phtty/nova_sensors/3d model/SW-SMD_2P-L5.1-W6.2-P2.54-LS9.4-BL.step

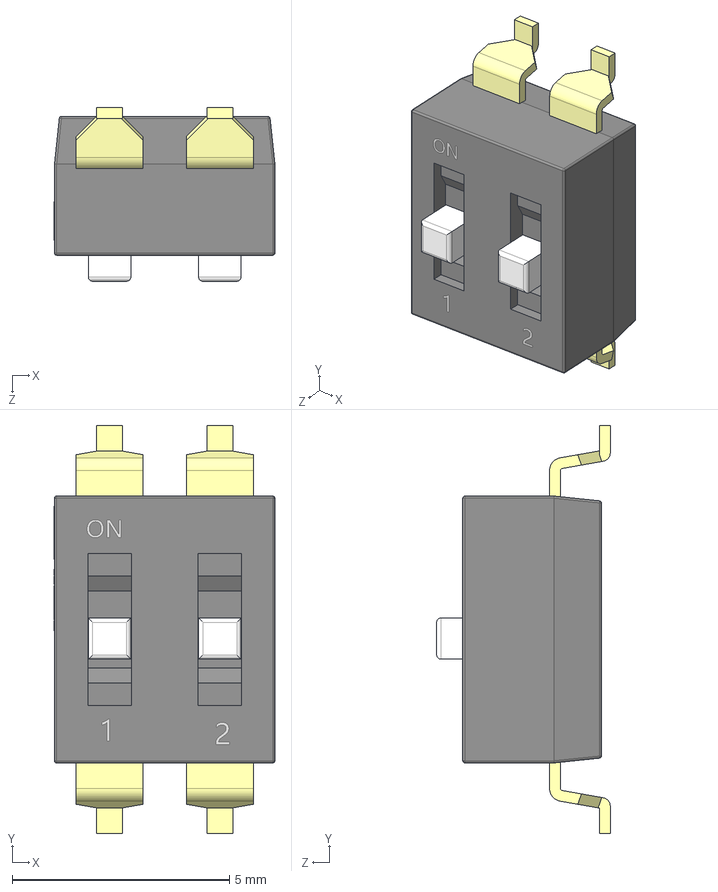
[picture p1: CAD file, 2026-08-21]
3d model/SW-SMD_2P-L5.1-W6.2-P2.54-LS9.4-BL.step
5.09 x 9.40 x 4.00 mm
