phtty/nova_sensors/3d model/L_12x12mm_H8mm.step

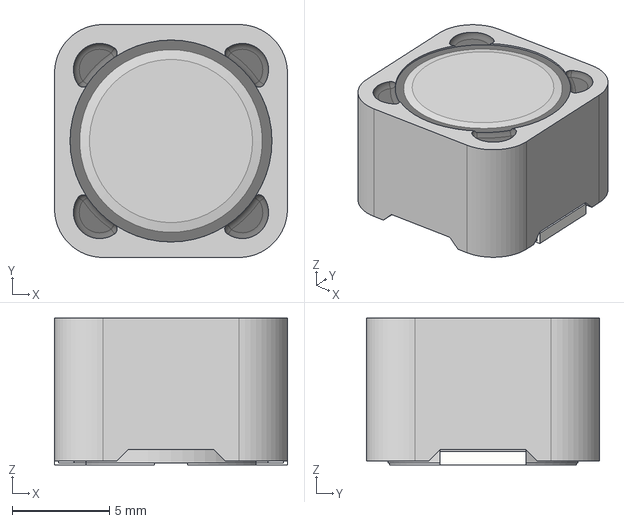
[picture p2: CAD file, 2026-08-21]
3d model/L_12x12mm_H8mm.step
12.0 x 12.0 x 7.56 mm
