phtty/nova_sensors/3d model/1812L125_16DR.stp

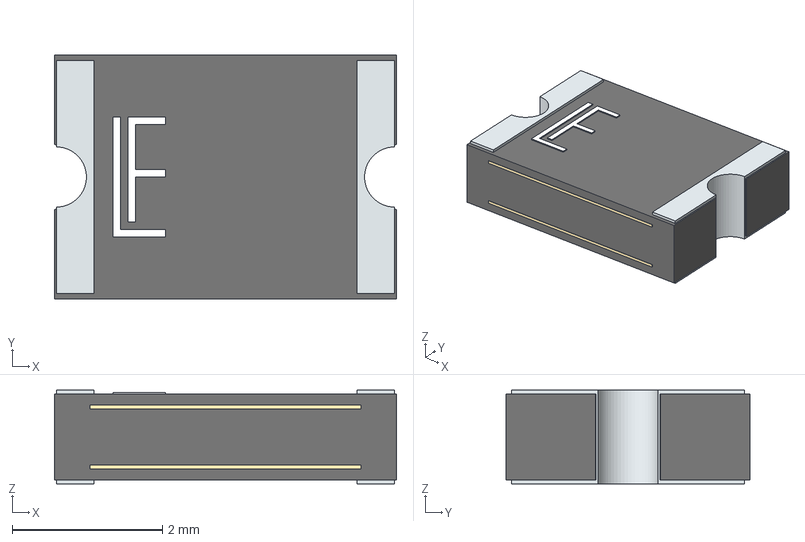
[picture p3: CAD file, 2026-08-21]
3d model/1812L125_16DR.stp
4.55 x 3.25 x 1.25 mm
Intersect
Terminal
solidWriting
