phtty/nova_sensors/nova_sensors.kicad_pcb

## KiCad design nova_sensors.kicad_pcb (2026-09-30)

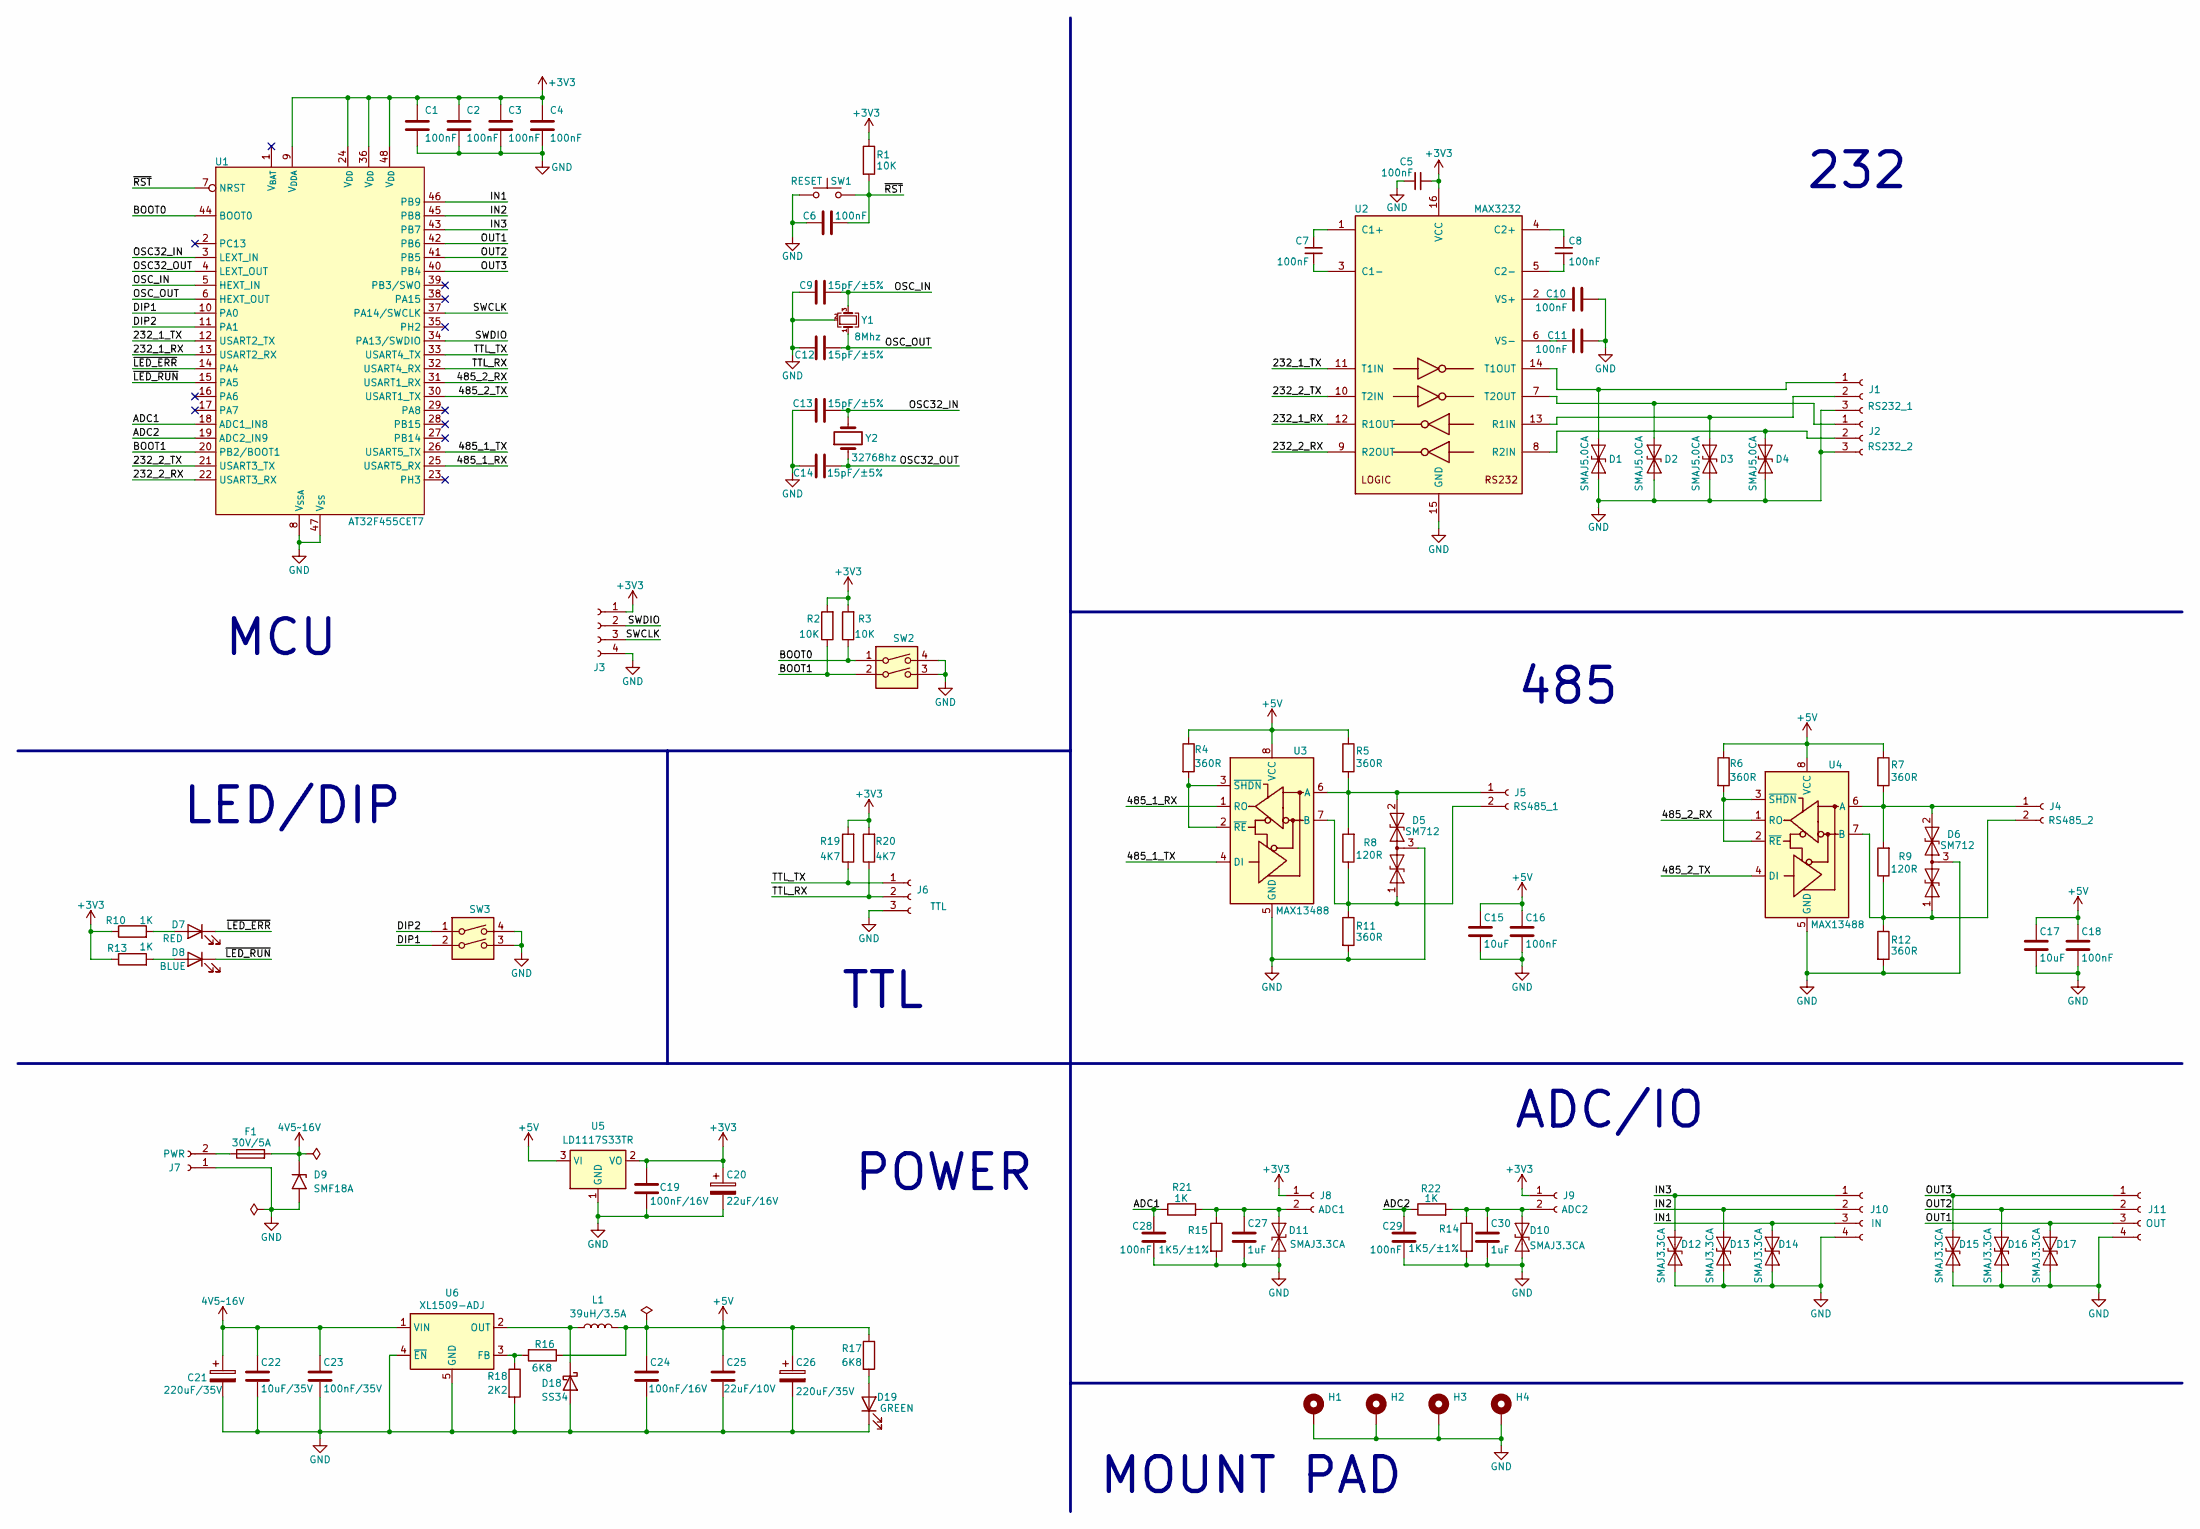
[picture p4: schematic nova_sensors.kicad_sch, 诺瓦传感器驱动板]

Parts:
C1, C2, C3, C4, C5, C6, C7, C8, C10, C11, C16, C18, C28, C29: 100nF; C_0603_1608Metric
C9, C12, C13, C14: 15pF/±5%; C_0603_1608Metric
C15, C17: 10uF; C_0603_1608Metric
C19, C24: 100nF/16V; C_0603_1608Metric
C20: 22uF/16V; CP_Elec_4x5.7
C21, C26: 220uF/35V; CP_Elec_8x10
C22: 10uF/35V; C_0603_1608Metric
C23: 100nF/35V; C_0603_1608Metric
C25: 22uF/10V; C_0603_1608Metric
C27, C30: 1uF; C_0603_1608Metric
D1, D2, D3, D4: SMAJ5.0CA; D_SMA
D5, D6: SM712; SOT-23
D7: RED; LED_0603_1608Metric_Pad1.05x0.95mm_HandSolder
D8: BLUE; LED_0603_1608Metric_Pad1.05x0.95mm_HandSolder
D9: SMF18A; D_SMF
D10, D11, D12, D13, D14, D15, D16, D17: SMAJ3.3CA; D_SMA
D18: SS34; D_SMA
D19: GREEN; LED_0603_1608Metric_Pad1.05x0.95mm_HandSolder
F1: 30V/5A; Fuse_1812_4532Metric_Pad1.30x3.40mm_HandSolder
H1: MountingHole_Pad; MountingHole_3.2mm_M3_Pad
H2, H3, H4: MountingHole_Pad; MountingHole_3.5mm_Pad
J1, J2, J6: Conn_01x03_Socket; PhoenixContact_MSTBA_2,5_3-G-5,08_1x03_P5.08mm_Horizontal
J3: Conn_01x04_Socket; JST_XH_B4B-XH-A_1x04_P2.50mm_Vertical
J4, J5, J7, J8, J9: Conn_01x02_Socket; PhoenixContact_MSTBA_2,5_2-G-5,08_1x02_P5.08mm_Horizontal
J10, J11: Conn_01x04_Socket; PhoenixContact_MSTBA_2,5_4-G-5,08_1x04_P5.08mm_Horizontal
L1: 39uH/3.5A; L_12x12mm_H8mm
R1, R2, R3: 10K; R_0603_1608Metric
R4, R5, R6, R7, R11, R12: 360R; R_0603_1608Metric
R8, R9: 120R; R_0603_1608Metric
R10, R13, R21, R22: 1K; R_0603_1608Metric
R14, R15: 1K5/±1%; R_0603_1608Metric
R16, R17: 6K8; R_0603_1608Metric
R18: 2K2; R_0603_1608Metric
R19, R20: 4K7; R_0603_1608Metric
SW1: SW_Push; SW_SPST_PTS647_Sx50
SW2, SW3: SW_DIP_x02; SW-SMD_2P-L5.1-W6.2-P2.54-LS9.4-BL
U1: AT32F455CET7; LQFP-48_7x7mm_P0.5mm
U2: MAX3232; SOIC-16_3.9x9.9mm_P1.27mm
U3, U4: MAX13488; SOIC-8_3.9x4.9mm_P1.27mm
U5: LD1117S33TR; SOT-223-3_TabPin2
U6: XL1509-ADJ; SOIC-8_3.9x4.9mm_P1.27mm
Y1: 8Mhz; Crystal_SMD_3225-4Pin_3.2x2.5mm
Y2: 32768hz; Crystal_SMD_3215-2Pin_3.2x1.5mm

Connections:
4V5~16V: C21.1, C22.1, C23.1, D9.1 (A1), F1.2, U6.1 (VIN)
+3V3: C1.1, C2.1, C3.1, C4.1, C5.2, C19.1, C20.1, J3.1, J8.1, J9.1, R1.1, R2.2, R3.2, R10.1, R13.1, R19.2, R20.2, U1.9 (V_{DDA}), U1.24 (V_{DD}), U1.36 (V_{DD}), U1.48 (V_{DD}), U2.16 (VCC), U5.2 (VO)
+5V: C15.1, C16.1, C17.1, C18.1, C24.1, C25.1, C26.1, L1.2, R4.1, R5.1, R6.1, R7.1, R16.1, R17.1, U3.8 (VCC), U4.8 (VCC), U5.3 (VI)
/232_1_RX: U1.13 (USART2_RX), U2.12 (R1OUT)
/232_1_TX: U1.12 (USART2_TX), U2.11 (T1IN)
/232_2_RX: U1.22 (USART3_RX), U2.9 (R2OUT)
/232_2_TX: U1.21 (USART3_TX), U2.10 (T2IN)
/485_1_RX: U1.25 (USART5_RX), U3.1 (RO)
/485_1_TX: U1.26 (USART5_TX), U3.4 (DI)
/485_2_RX: U1.31 (USART1_RX), U4.1 (RO)
/485_2_TX: U1.30 (USART1_TX), U4.4 (DI)
/ADC1: C28.1, R21.1, U1.18 (ADC1_IN8)
/ADC2: C29.1, R22.1, U1.19 (ADC2_IN9)
/BOOT0: R3.1, SW2.1, U1.44 (BOOT0)
/BOOT1: R2.1, SW2.2, U1.20 (PB2/BOOT1)
/DIP1: SW3.2, U1.10 (PA0)
/DIP2: SW3.1, U1.11 (PA1)
/IN1: D14.2 (A2), J10.3, U1.46 (PB9)
/IN2: D13.2 (A2), J10.2, U1.45 (PB8)
/IN3: D12.2 (A2), J10.1, U1.43 (PB7)
/OSC32_IN: C13.2, U1.3 (LEXT_IN), Y2.2
/OSC32_OUT: C14.1, U1.4 (LEXT_OUT), Y2.1
/OSC_IN: C9.2, U1.5 (HEXT_IN), Y1.3
/OSC_OUT: C12.1, U1.6 (HEXT_OUT), Y1.1
/OUT1: D17.2 (A2), J11.3, U1.42 (PB6)
/OUT2: D16.2 (A2), J11.2, U1.41 (PB5)
/OUT3: D15.2 (A2), J11.1, U1.40 (PB4)
/SWCLK: J3.3, U1.37 (PA14/SWCLK)
/SWDIO: J3.2, U1.34 (PA13/SWDIO)
/TTL_RX: J6.2, R20.1, U1.32 (USART4_RX)
/TTL_TX: J6.1, R19.1, U1.33 (USART4_TX)
/~LED_ERR: D7.1 (K), U1.14 (PA4)
/~LED_RUN: D8.1 (K), U1.15 (PA5)
/~RST: C6.2, R1.2, SW1.2, U1.7 (NRST)
GND: C1.2, C2.2, C3.2, C4.2, C5.1, C6.1, C9.1, C10.2, C11.2, C12.2, C13.1, C14.2, C15.2, C16.2, C17.2, C18.2, C19.2, C20.2, C21.2, C22.2, C23.2, C24.2, C25.2, C26.2, C27.2, C28.2, C29.2, C30.2, D1.1 (A1), D2.1 (A1), D3.1 (A1), D4.1 (A1), D5.3 (common), D6.3 (common), D9.2 (A2), D10.1 (A1), D11.1 (A1), D12.1 (A1), D13.1 (A1), D14.1 (A1), D15.1 (A1), D16.1 (A1), D17.1 (A1), D18.2 (A), D19.1 (K), H1.1 (1_1), H2.1 (1_1), H3.1 (1_1), H4.1 (1_1), J1.3, J2.3, J3.4, J6.3, J7.1, J10.4, J11.4, R11.2, R12.2, R14.2, R15.2, R18.2, SW1.1, SW2.3, SW2.4, SW3.3, SW3.4, U1.8 (V_{SSA}), U1.47 (V_{SS}), U2.15 (GND), U3.5 (GND), U4.5 (GND), U5.1 (GND), U6.4 (~EN), U6.5 (GND), U6.6 (GND), U6.7 (GND), U6.8 (GND), Y1.2 (G), Y1.4 (G)
unnamed: D1.2 (A2), J1.1, U2.14 (T1OUT)
unnamed: D2.2 (A2), J2.1, U2.7 (T2OUT)
unnamed: D3.2 (A2), J1.2, U2.13 (R1IN)
unnamed: D4.2 (A2), J2.2, U2.8 (R2IN)
unnamed: D5.1 (A1), J5.2, R8.1, R11.1, U3.7 (B)
unnamed: D5.2 (A2), J5.1, R5.2, R8.2, U3.6 (A)
unnamed: D6.1 (A1), J4.2, R9.1, R12.1, U4.7 (B)
unnamed: D6.2 (A2), J4.1, R7.2, R9.2, U4.6 (A)
unnamed: D7.2 (A), R10.2
unnamed: D8.2 (A), R13.2
unnamed: C30.1, D10.2 (A2), J9.2, R14.1, R22.2
unnamed: C27.1, D11.2 (A2), J8.2, R15.1, R21.2
unnamed: D18.1 (K), L1.1, U6.2 (OUT)
unnamed: D19.2 (A), R17.2
unnamed: F1.1, J7.2
unnamed: C7.1, U2.1 (C1+)
unnamed: C7.2, U2.3 (C1-)
unnamed: C8.1, U2.4 (C2+)
unnamed: C8.2, U2.5 (C2-)
unnamed: C10.1, U2.2 (VS+)
unnamed: C11.1, U2.6 (VS-)
unnamed: R4.2, U3.2 (~RE), U3.3 (~SHDN)
unnamed: R6.2, U4.2 (~RE), U4.3 (~SHDN)
unnamed: R16.2, R18.1, U6.3 (FB)

Notes on the sheet:
MOUNT PAD
LED/DIP
POWER
MCU
232
ADC/IO
485
TTL

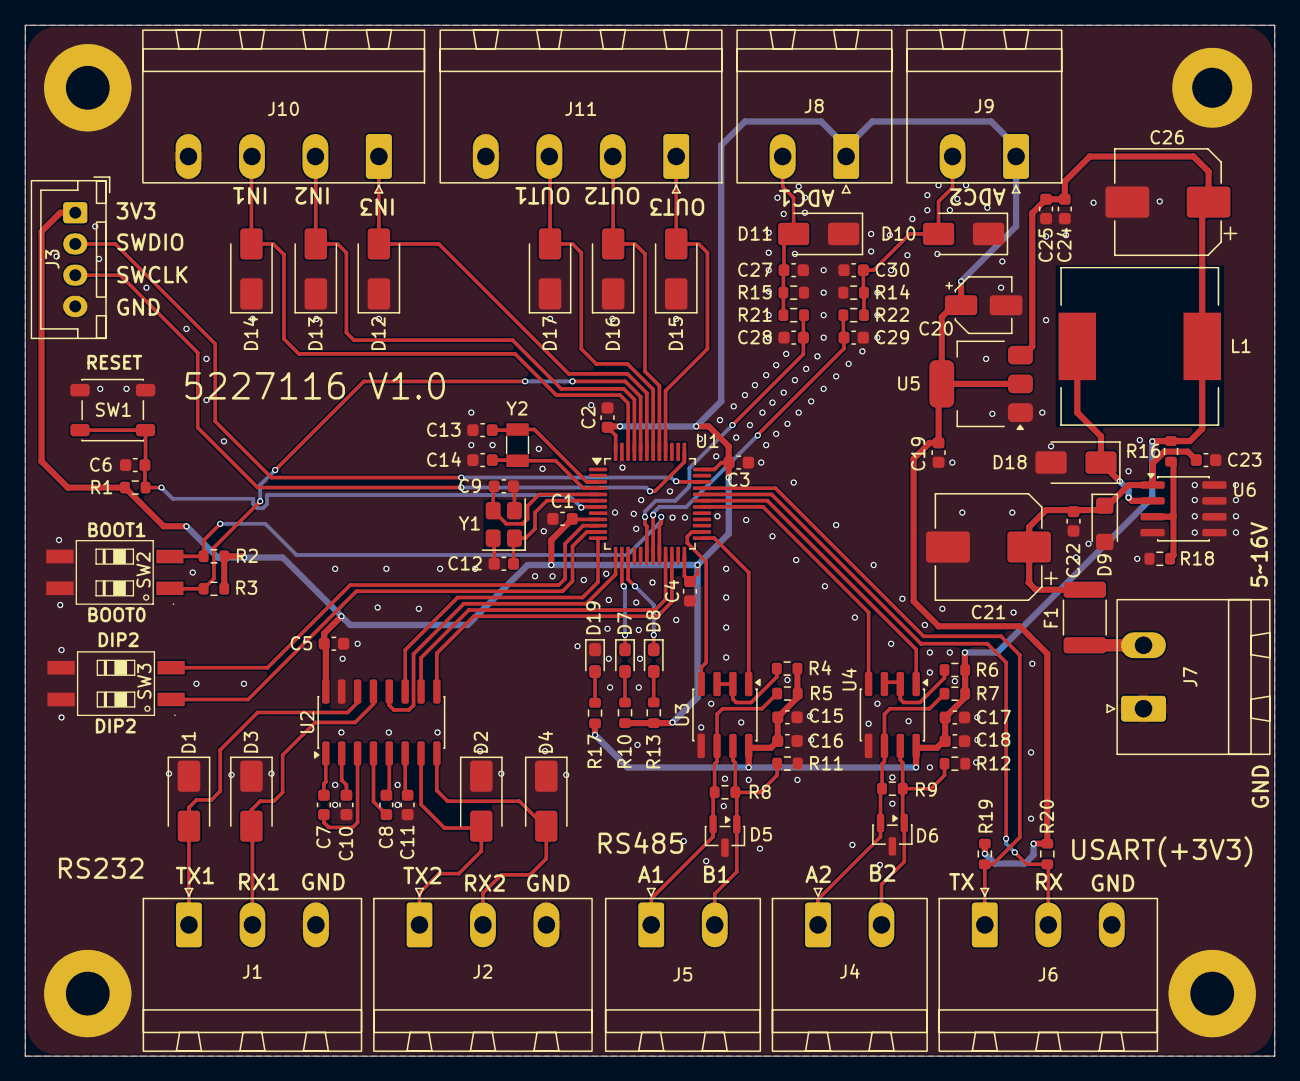
[picture p5: board nova_sensors.kicad_pcb from above]

Board: 2 copper layers, 100.0 x 82.5 mm, 99 parts (0 on the bottom side), 59 nets.
