phtty/nova_sensors/(commit log)

2026-08-26 refact: 重新排列引脚，使得布局更合理，同时压缩板子面积
    [nova_sensors.kicad_pcb, nova_sensors.kicad_sch]
2026-08-26 feat: 添加了at32 workbench的工程文件，方便查阅引脚定义和功能
2026-08-26 fix: 修复了at32f455符号的adc通道1和通道2没有分开的问题
    [nova_sensors.kicad_sch]
2026-08-26 fix: 修复debug口线序反了的问题
    [nova_sensors.kicad_sch]
2026-08-27 refact: 完成V0.0.2版本的布线和DRC检测
    [nova_sensors.kicad_pcb, nova_sensors.kicad_sch]
2026-08-31 chore: 停止追踪produc/目录并更新.gitignore
    [nova_sensors-B_Cu.gbr, nova_sensors-B_Mask.gbr, nova_sensors-B_Paste.gbr, nova_sensors-B_Silkscreen.gbr, nova_sensors-Edge_Cuts.gbr, nova_sensors-F_Cu.gbr, nova_sensors-F_Mask.gbr, nova_sensors-F_Paste.gbr]
2026-08-31 refact: 调整PCB丝印和原理图符号位置
    [nova_sensors.kicad_pcb, nova_sensors.kicad_sch]
2026-08-31 doc: 图纸的时间修改
    [nova_sensors.kicad_sch]
2026-08-31 refact: 调整丝印与网络标签，更新AT32 WorkBench配置
    - PCB: 调整ADC1丝印位置并取消锁定
    - SCH: 网络标签重命名 ADC_IN0->ADC1, ADC_IN1->ADC2
    - ATWP: 工程重命名为nova_sensors，新增WDT/TMR1/DMA及串口中断等外设配置
    [nova_sensors.kicad_pcb, nova_sensors.kicad_sch]
2026-08-31 fix: 修复工程专用符号库中485芯片缺失的问题，同时调整了485芯片的封装并更新了pcb
    [nova_sensors.kicad_pcb, nova_sensors.kicad_sch]
2026-09-01 fix: 调整电源指示灯的限流电阻大小，使其与其他两个灯亮度相近；调整装配图的说明文字位置，使其易于辨认
    [nova_sensors.kicad_pcb, nova_sensors.kicad_sch]
2026-09-02 fix: 微调丝印位置
    [nova_sensors.kicad_pcb, nova_sensors.kicad_sch]
2026-09-07 fix: 修正了装配图的一些问题
    [nova_sensors.kicad_pcb]
2026-09-15 fix: 修改ADC电路，将RL分压方向改为接地端；mcu侧增加限流电阻和滤波电容；Rx侧增加滤波电容
    [nova_sensors.kicad_pcb, nova_sensors.kicad_sch]
2026-09-15 fix: 调整丝印位置
    [nova_sensors.kicad_pcb]
2026-09-29 doc: 修改原理图版本，生成各种生产资料
    [nova_sensors.kicad_pcb, nova_sensors.kicad_sch]
2026-09-30 fix: 调整一处3.3V走线和过孔
    [nova_sensors.kicad_pcb]
2026-09-30 fix: 原理图调整晶振负载电容容值和精度，PCB新增编码丝印
    [nova_sensors.kicad_pcb, nova_sensors.kicad_sch]
